LGustta13/Projeto_Controle_de_Temperatura/docs/Lab. Apresentação.pdf

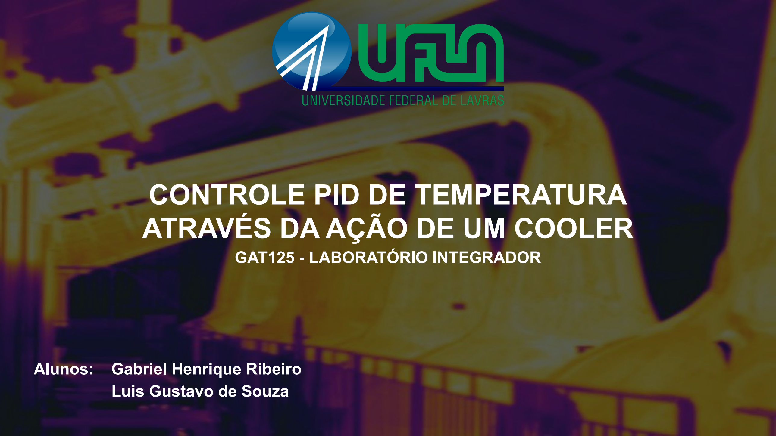
[picture p33: page 1]

### CONTROLE PID DE TEMPERATURA ATRAVÉS DA AÇÃO DE UM COOLER

GAT125 - LABORATÓRIO INTEGRADOR

Alunos: Gabriel Henrique Ribeiro Luis Gustavo de Souza

Introdução

- Objetivo
- Controle de temperatura em um ambiente fechado
- Desenvolvimento de dois modelos de controladores
- Fluxograma geral

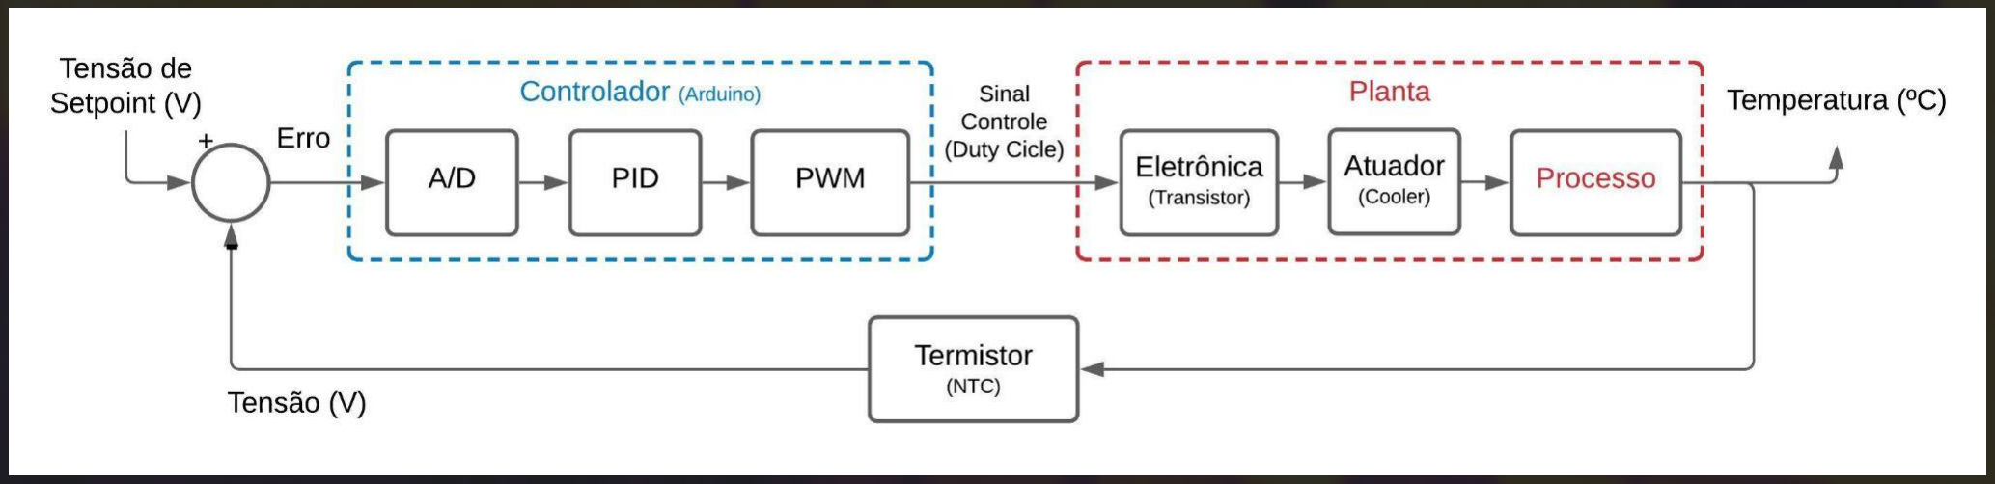
[picture p34: figure]
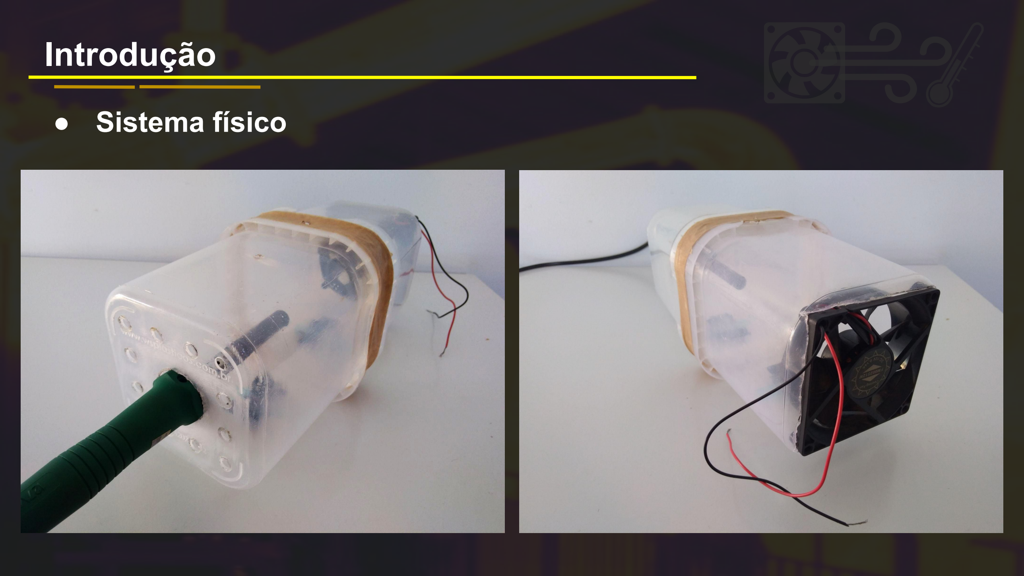
[picture p35: page 3]

Introdução

- Sistema físico

Resultados

- Modelo estimado

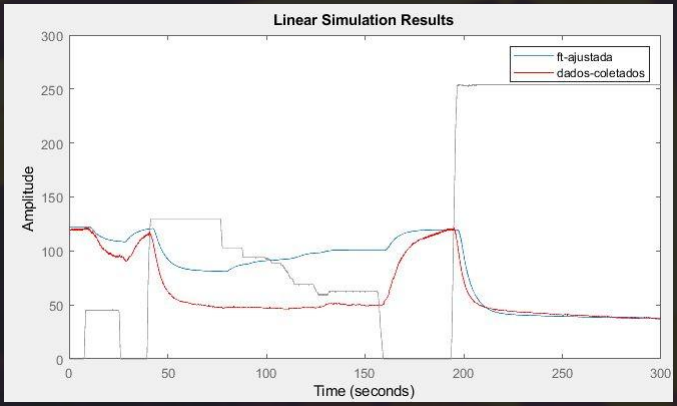
[picture p36: figure]
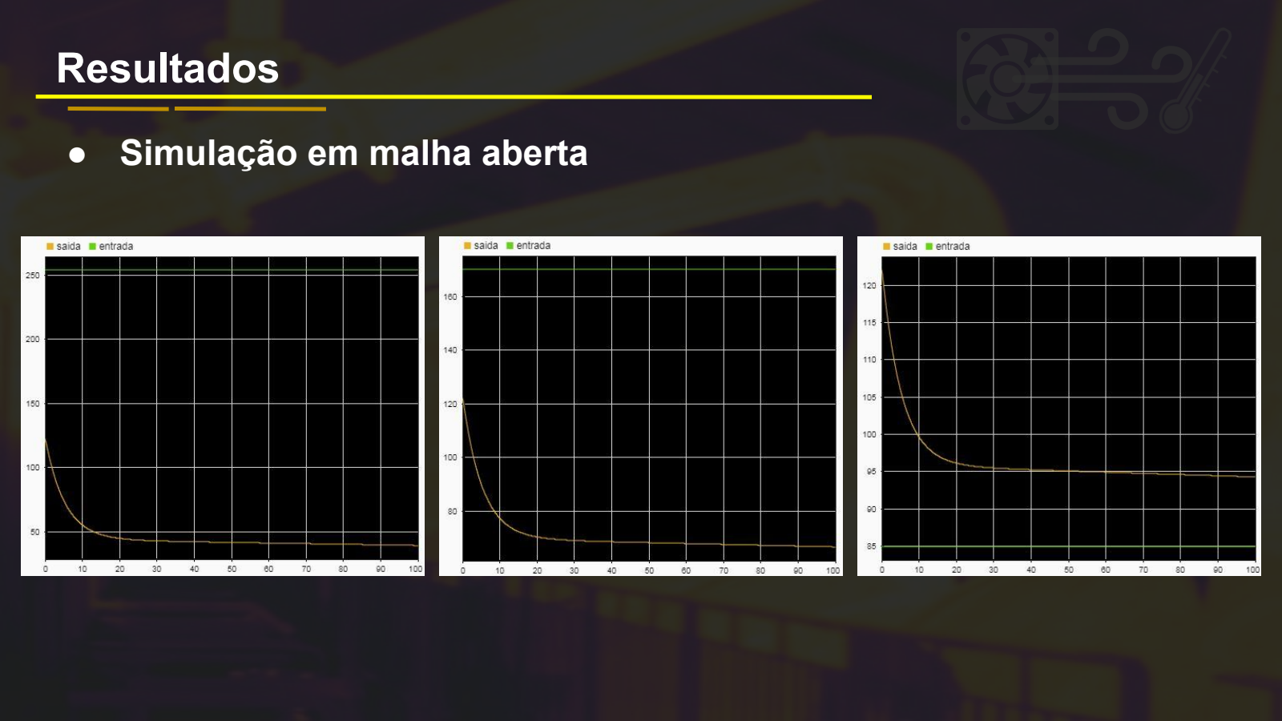
[picture p37: page 5]

Resultados

- Simulação em malha aberta

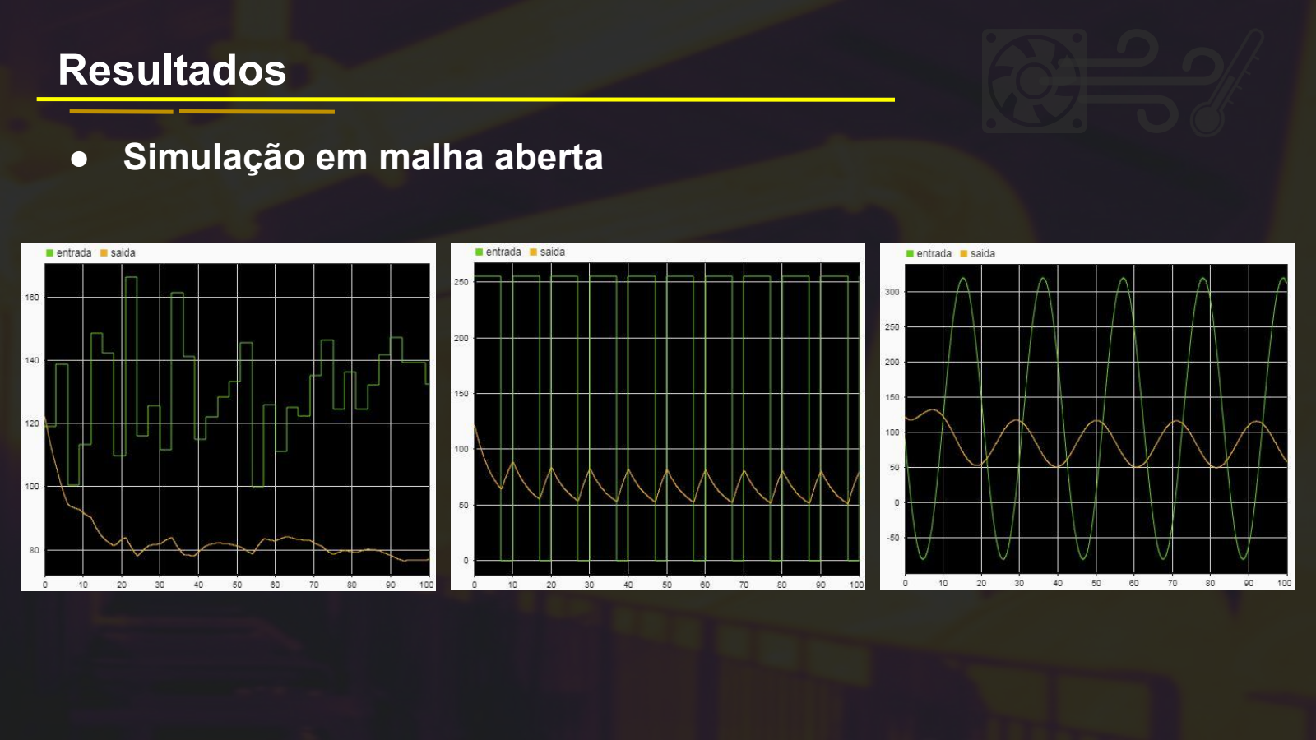
[picture p38: page 6]

Resultados

- Simulação em malha aberta

Resultados

- Simulação em malha fechada com controle PID

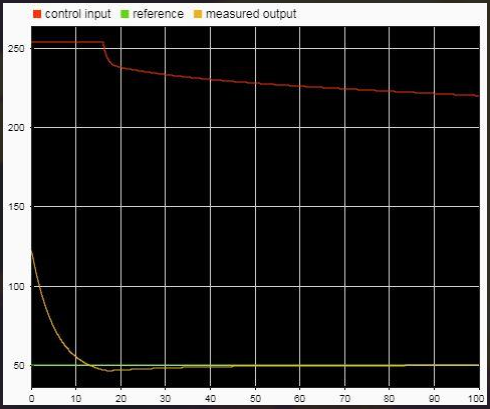
[picture p39: figure]

Resultados

- Simulação em malha fechada com controle no espaço de estados

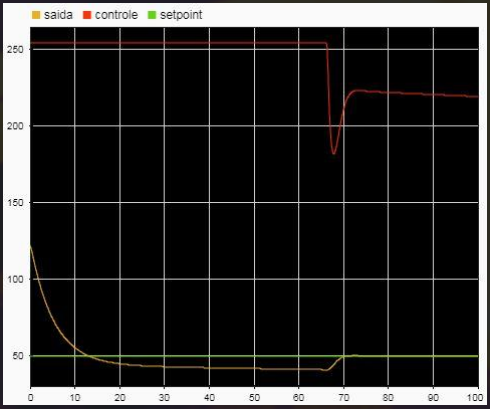
[picture p40: figure]

Resultados

- Controle PID no sistema físico

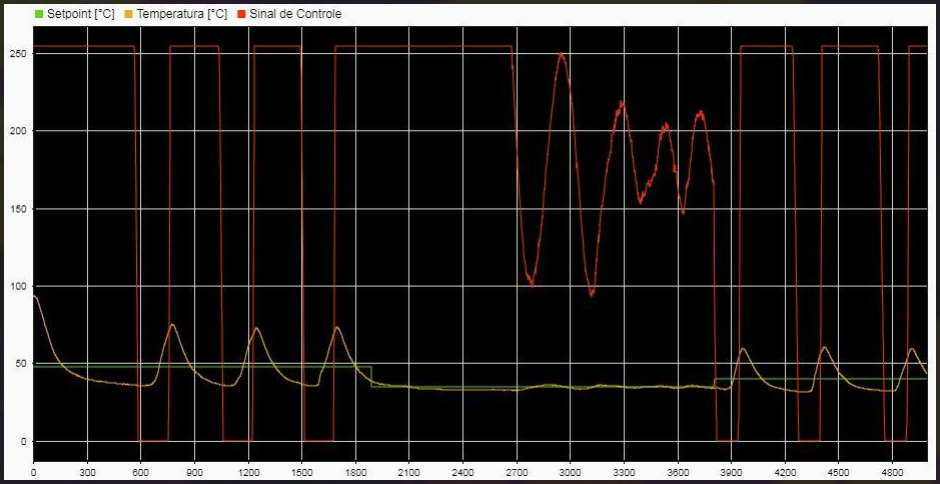
[picture p41: figure]

Resultados

- Controle no espaço de estados no sistema físico

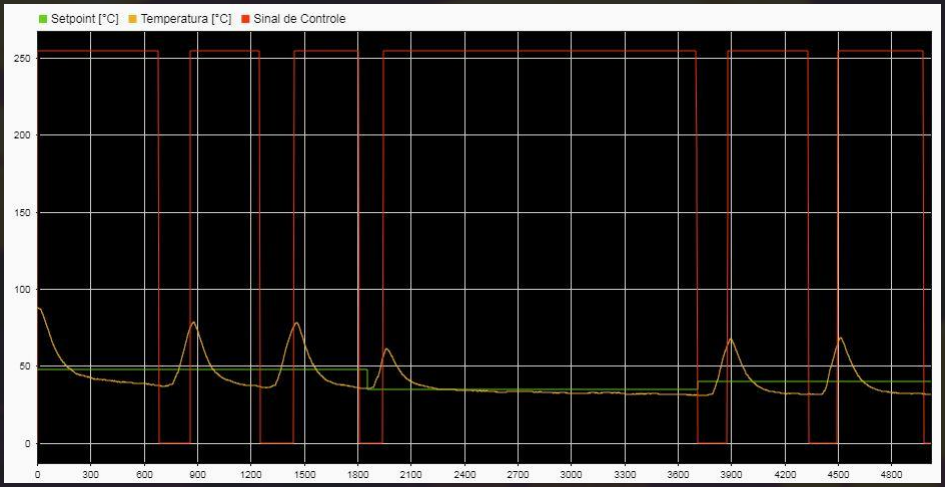
[picture p42: figure]

Resultados

- Controle PID no sistema físico com ajustes

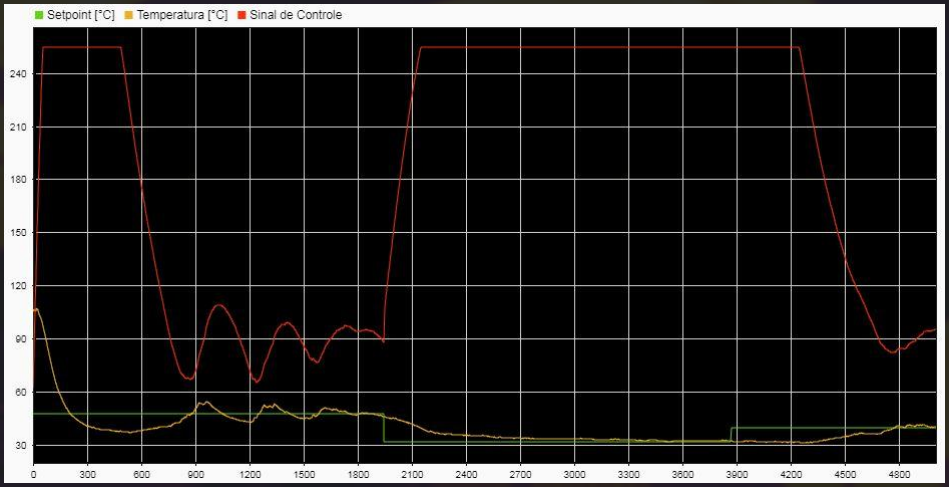
[picture p43: figure]

Resultados

- Controle no espaço de estados no sistema físico com ajustes

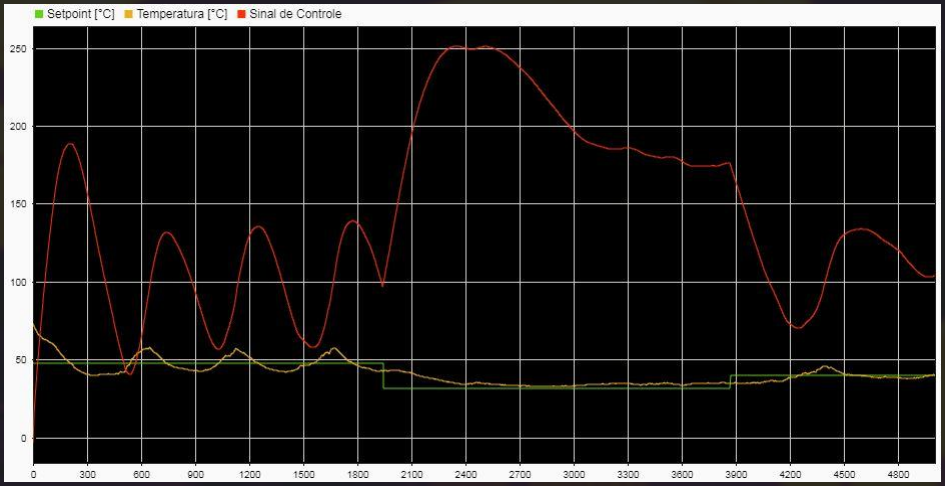
[picture p44: figure]

Resultados

- Comparação dos controladores ajustados

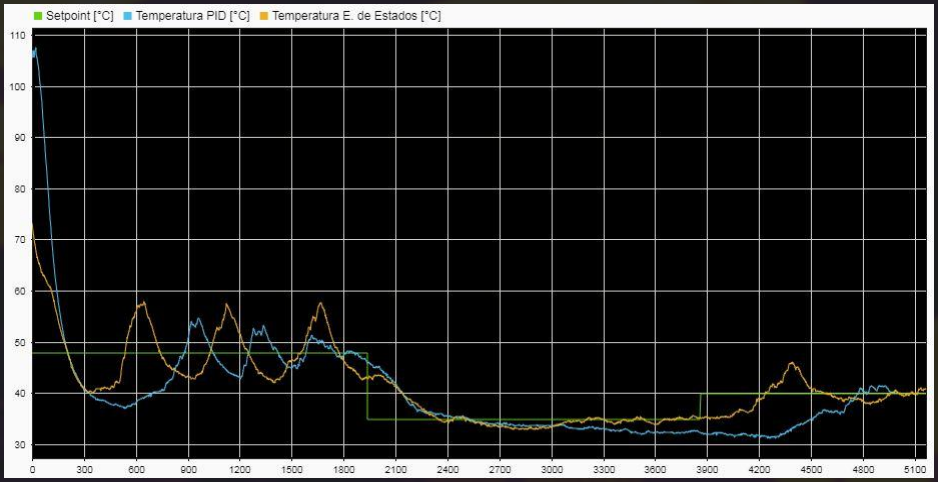
[picture p45: figure]
