LGustta13/Projeto_Controle_de_Temperatura/assets/side1.jpg

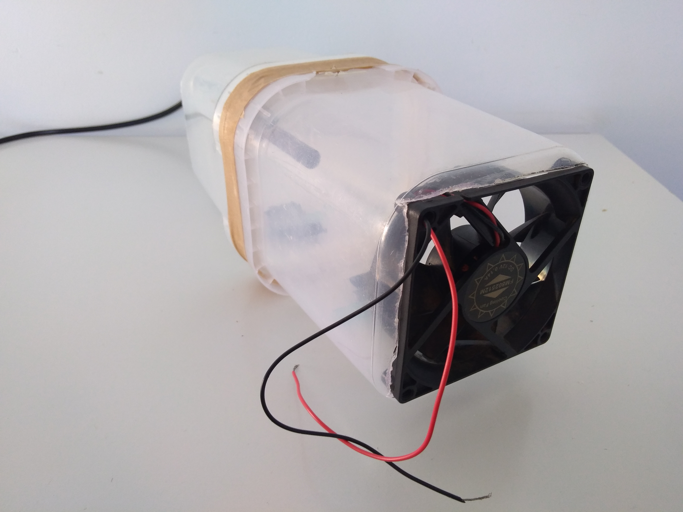
assets/side1.jpg
