LGustta13/Projeto_Controle_de_Temperatura/board/Proteus/Esquemático.pdf

U1

R1

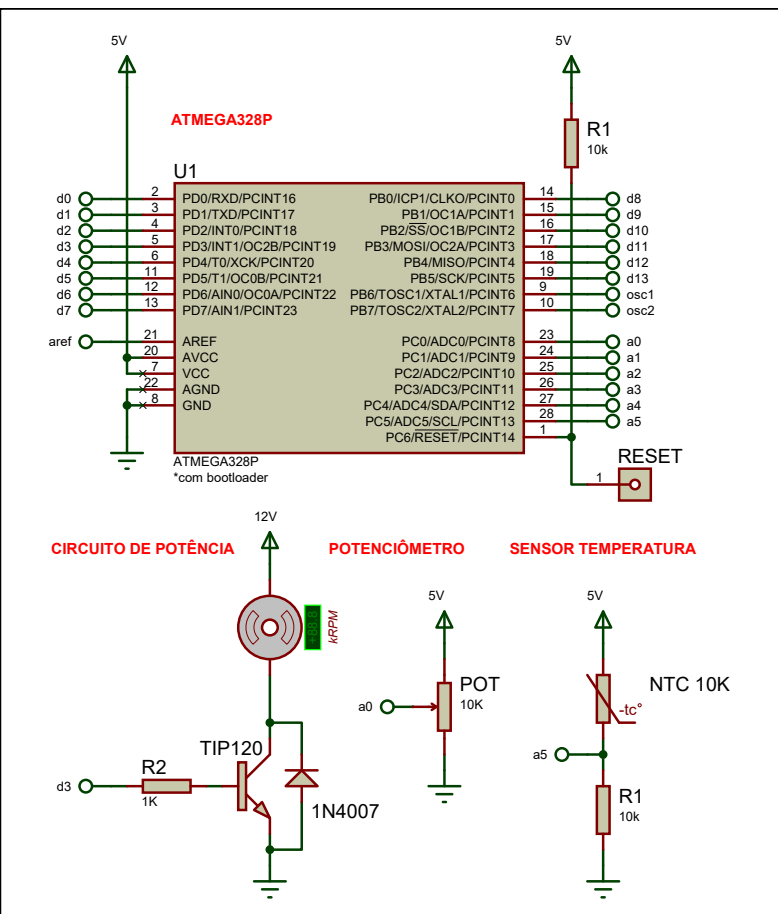
[picture p54: page 1]
PB0/ICP1/CLKO/PCINT0; PB1/OC1A/PCINT1; PB3/MOSI/OC2A/PCINT3; 17 PB2/SS/OC1B/PCINT2; PD6/AIN0/OC0A/PCINT22 12; PD5/T1/OC0B/PCINT21 11; PD4/T0/XCK/PCINT20 6; PD3/INT1/OC2B/PCINT19 5; PD2/INT0/PCINT18 4; PD1/TXD/PCINT17 3; PD0/RXD/PCINT16 2; PB4/MISO/PCINT4; PB5/SCK/PCINT5; PB7/TOSC2/XTAL2/PCINT7; 10 PB6/TOSC1/XTAL1/PCINT6; PC6/RESET/PCINT14; PC5/ADC5/SCL/PCINT13; 28 PC4/ADC4/SDA/PCINT12; 27 PC3/ADC3/PCINT11; 26 PC2/ADC2/PCINT10; 25 PC1/ADC1/PCINT9; 24 PC0/ADC0/PCINT8; AVCC 20; AREF 21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
