LGustta13/Projeto_Controle_de_Temperatura/(list of files, drawings)

Other design files:
board/Proteus/arduino_standalone.DSN
