LGustta13/Projeto_Controle_de_Temperatura/(commit log)

2023-08-24 Modelagem do sistema
    [Sistema.csv, Sistema2.xlsx, Sistema3.xlsx, Sistema4.xlsx, dados3setAgressividade15.xlsm, dados3setSemAgressividade.xlsm, dadosACKERcomPonderamento0_009.xlsm, dadosACKERsemPonderamento.xlsm]
2023-08-24 Aquisição dos dados
    [PLX-DAQ-v2.11.xlsm]
2023-08-24 Desenho do esquemático do circuito eletrônico
    [arduino_standalone.DSN]
2023-09-05 Organização dos arquivos
    [PLX-DAQ-v2.11.xlsm, Sistema.csv, Sistema2.xlsx, Sistema3.xlsx, Sistema4.xlsx, arduino_standalone.DSN, dados3setAgressividade15.xlsm, dados3setSemAgressividade.xlsm]
